leptun/leptunKicadLib/SR4G080.step

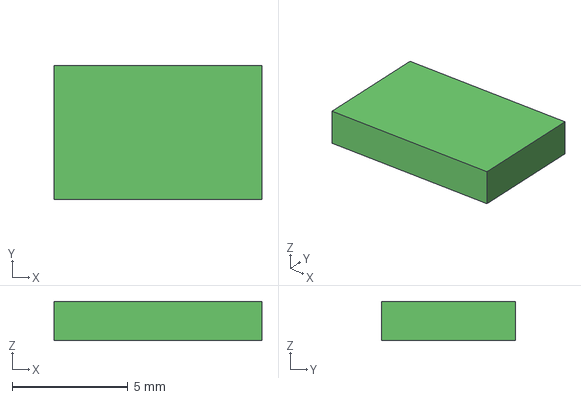
[picture p1: CAD file, 2023-09-09]
SR4G080.step
9.00 x 5.80 x 1.69 mm
