leptun/leptunKicadLib/TPS2053BDR.stp

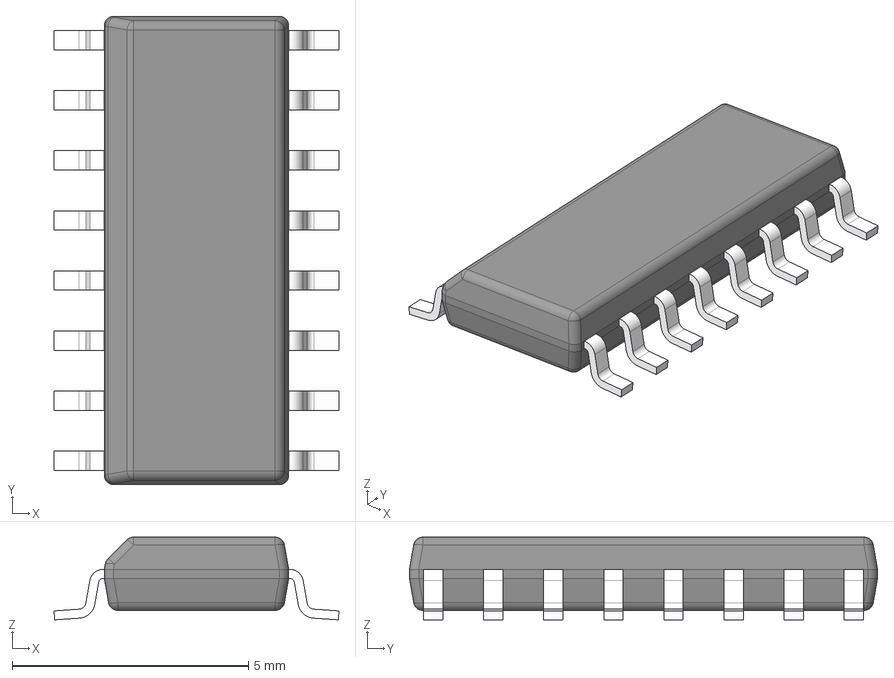
[picture p2: CAD file, 2023-08-23]
TPS2053BDR.stp
6.03 x 9.90 x 1.75 mm
BODY-SO
LEAD-SO x 16
PIN1-ID
