leptun/leptunKicadLib/PI3USB4000DZUAEX.stp

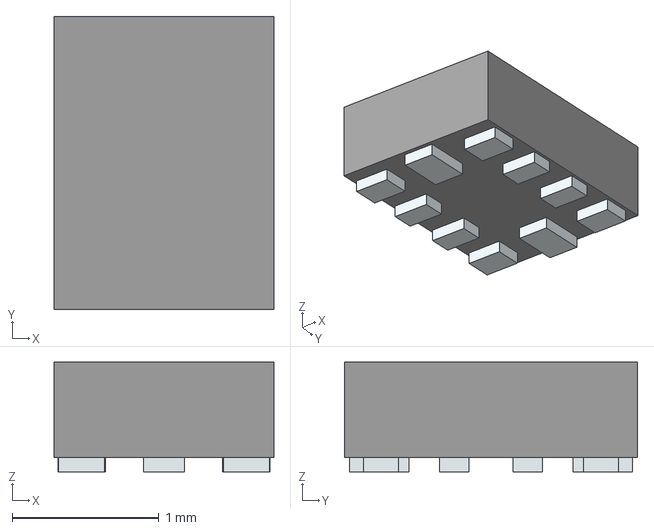
[picture p3: CAD file, 2023-08-23]
PI3USB4000DZUAEX.stp
1.50 x 2.00 x 0.75 mm
Pins
