leptun/leptunKicadLib/33UBAR-TSN1R.stp

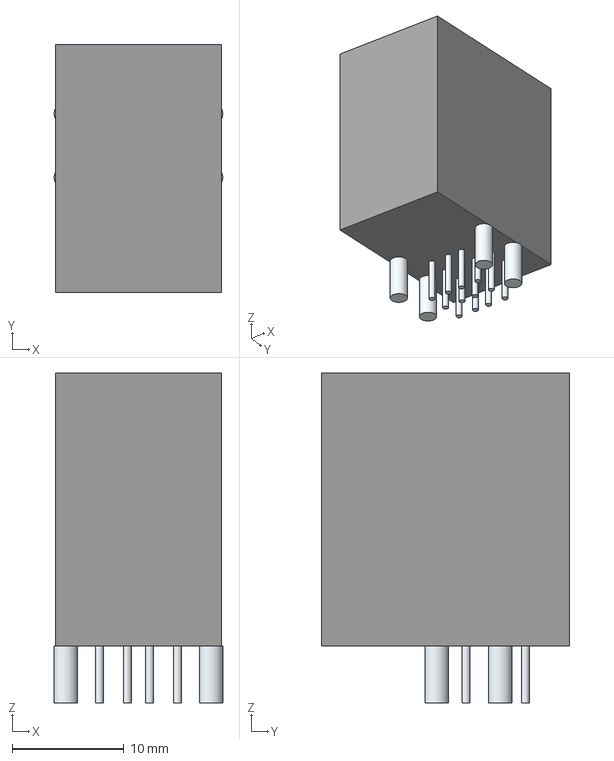
[picture p4: CAD file, 2023-08-23]
33UBAR-TSN1R.stp
15.1 x 22.2 x 29.6 mm
Leads
