leptun/leptunKicadLib/MC74VHC1G08DBVT1G.stp

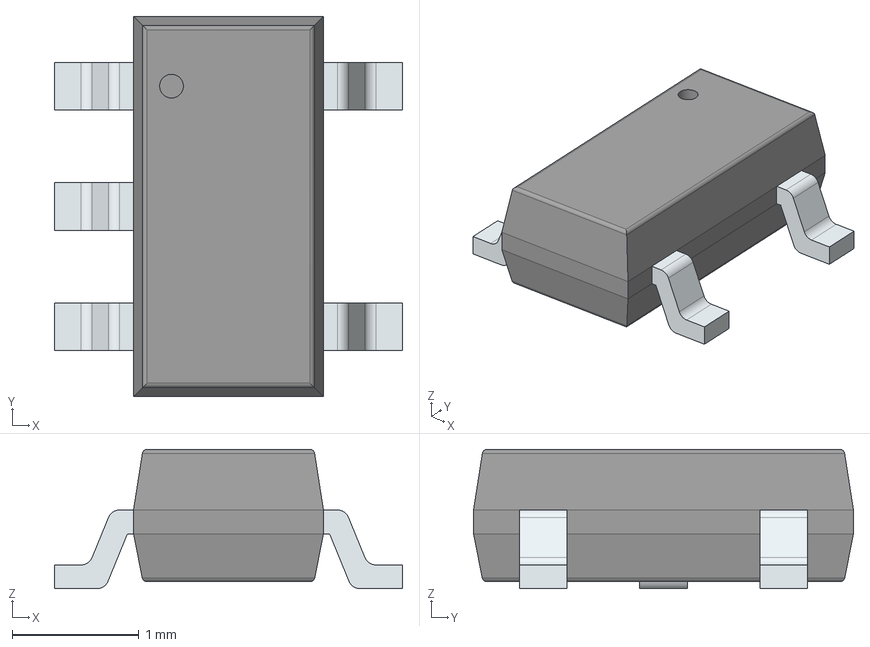
[picture p5: CAD file, 2023-08-23]
MC74VHC1G08DBVT1G.stp
2.75 x 3.00 x 1.10 mm
PinsArrayL
PinsArrayR
