leptun/leptunKicadLib/TS5USBC412YFFR.stp

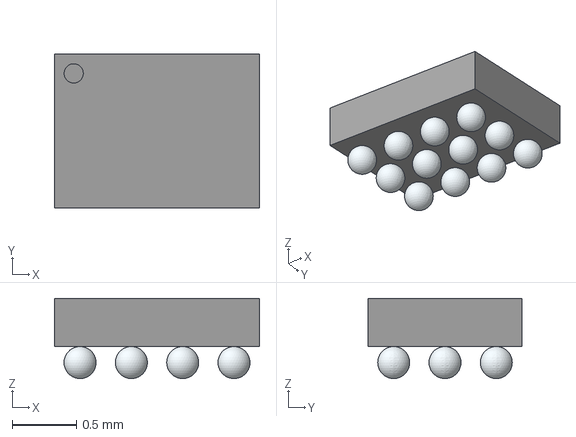
[picture p6: CAD file, 2023-08-23]
TS5USBC412YFFR.stp
1.60 x 1.20 x 0.625 mm
