leptun/leptunKicadLib/FSM4JSMAATR.stp

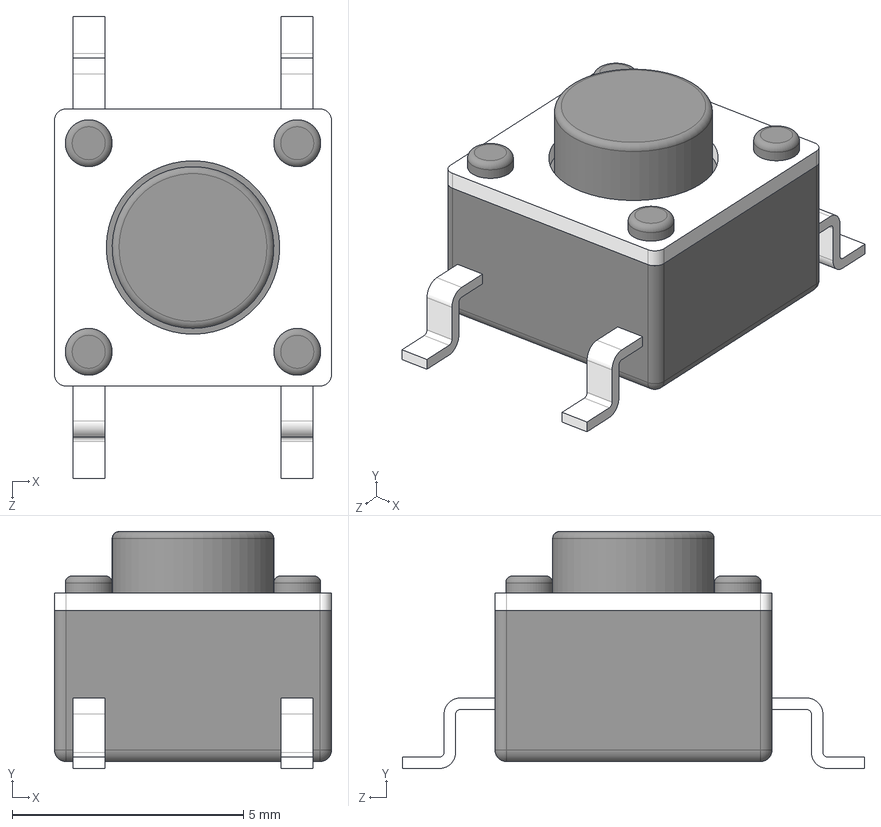
[picture p7: CAD file, 2023-08-23]
FSM4JSMAATR.stp
6.00 x 5.13 x 10.0 mm
