leptun/leptunKicadLib/DTSM-61N-V-T_R.step

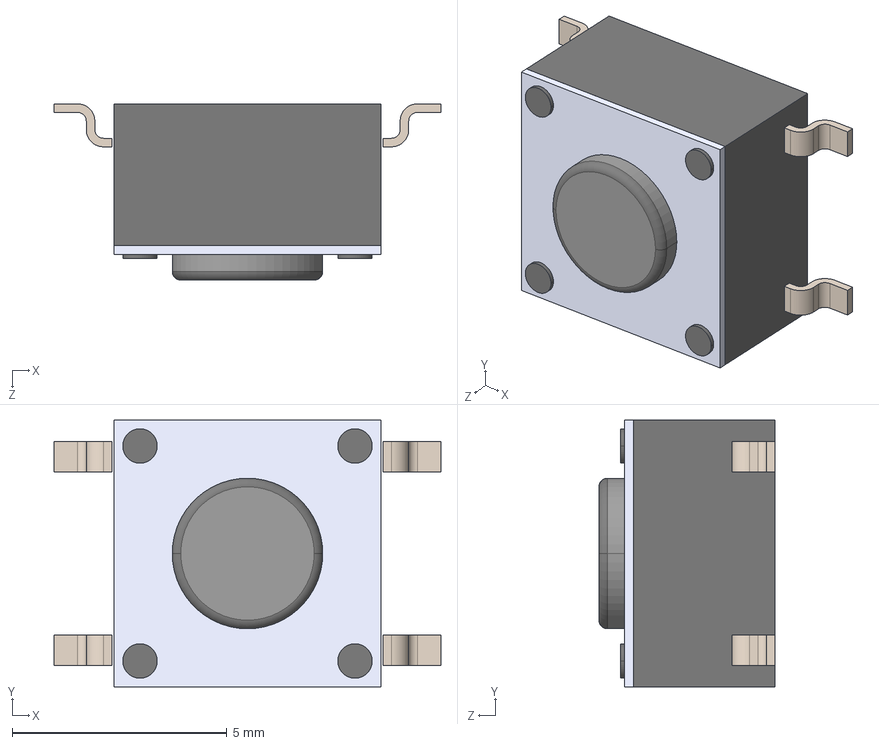
[picture p8: CAD file, 2021-10-09]
DTSM-61N-V-T_R.step
9.00 x 6.20 x 4.10 mm
