leptun/leptunKicadLib/AOZ1212AI.step

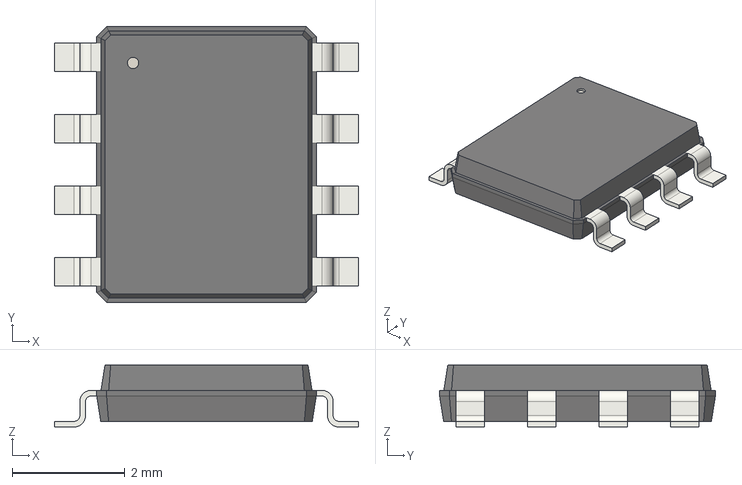
[picture p9: CAD file, 2021-10-09]
AOZ1212AI.step
5.40 x 4.90 x 1.10 mm
