leptun/leptunKicadLib/SRP6530A-6R8M.stp

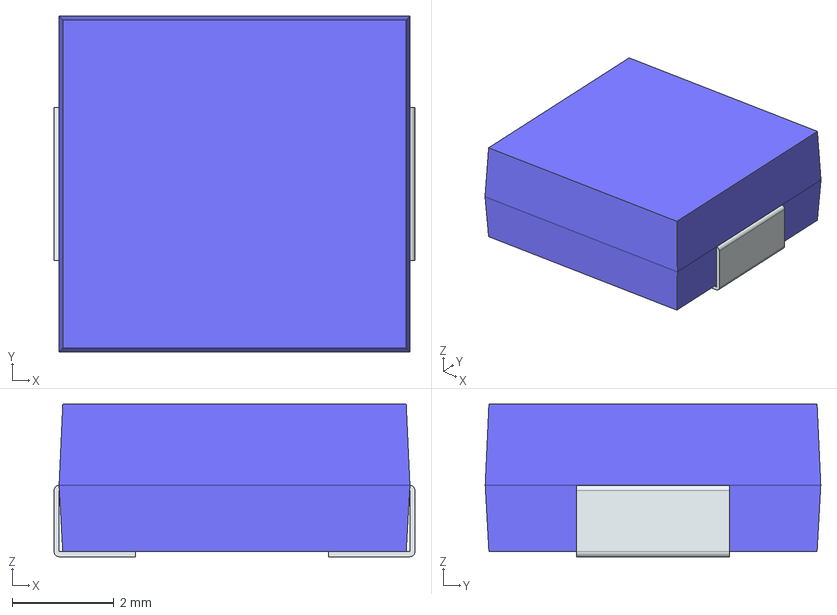
[picture p10: CAD file, 2021-10-09]
SRP6530A-6R8M.stp
7.10 x 6.60 x 3.00 mm
FilletPin1
FilletPin2
