leptun/leptunKicadLib/ATS240C.STEP

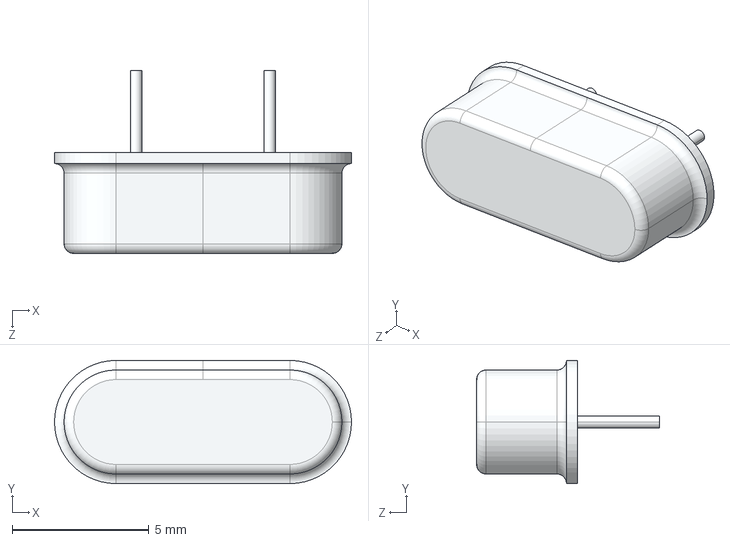
[picture p11: CAD file, 2021-10-09]
ATS240C.STEP
10.8 x 4.50 x 6.68 mm
