leptun/leptunKicadLib/STM32G441KBU6.stp

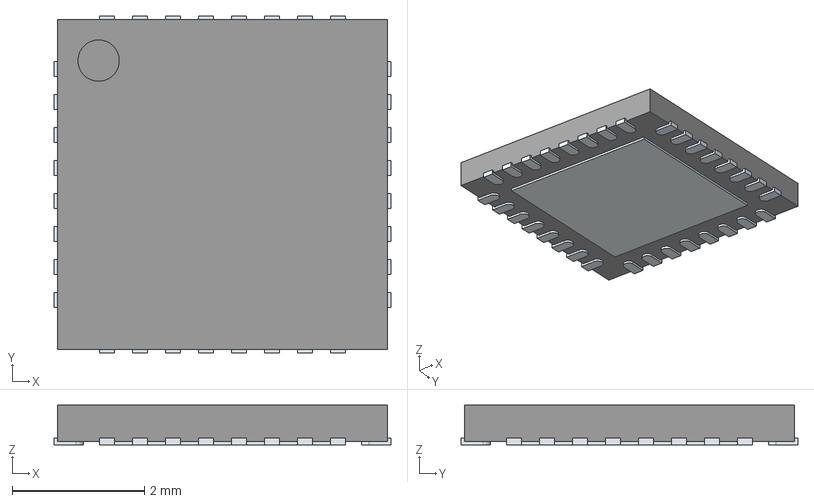
[picture p12: CAD file, 2021-10-09]
STM32G441KBU6.stp
5.10 x 5.10 x 0.6 mm
ThermalPin
PinsArrayLR
PinsArrayTB
