leptun/leptunKicadLib/FTSH-107-01-L-DV-K-A.stp

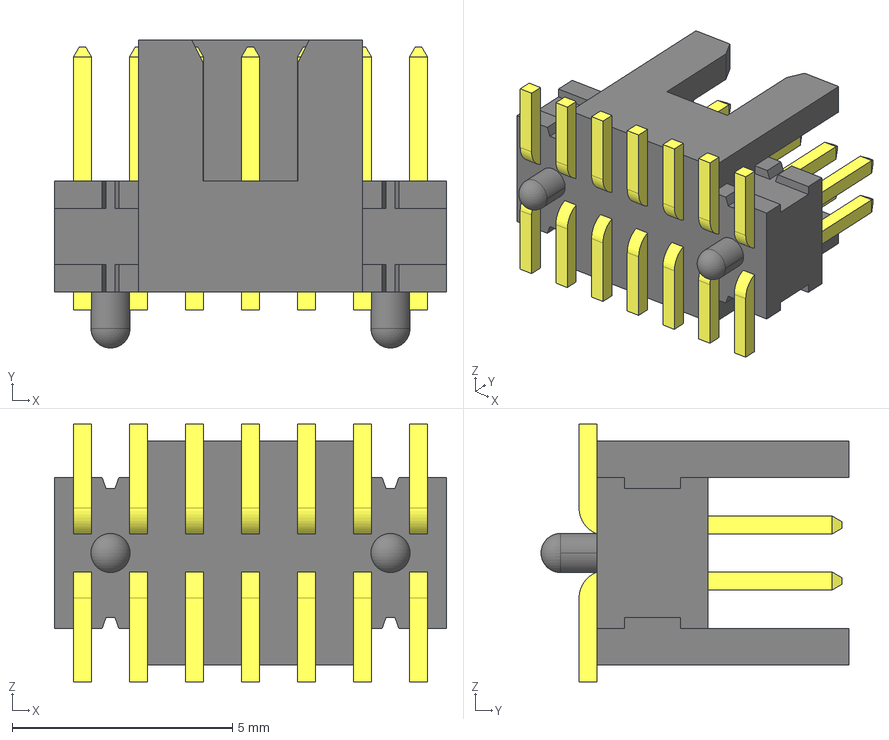
[picture p13: CAD file, 2021-10-09]
FTSH-107-01-L-DV-K-A.stp
8.89 x 6.98 x 5.84 mm
