leptun/leptunKicadLib/TS3USBCA420RSVR.stp

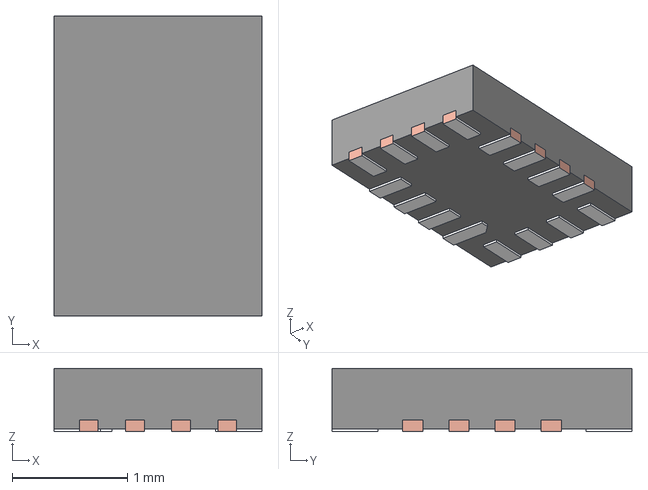
[picture p14: CAD file, 2021-10-08]
TS3USBCA420RSVR.stp
1.80 x 2.60 x 0.55 mm
BODY-SON1
FRAME-RSV0016A
