leptun/leptunKicadLib/USB4110-GF-A.stp

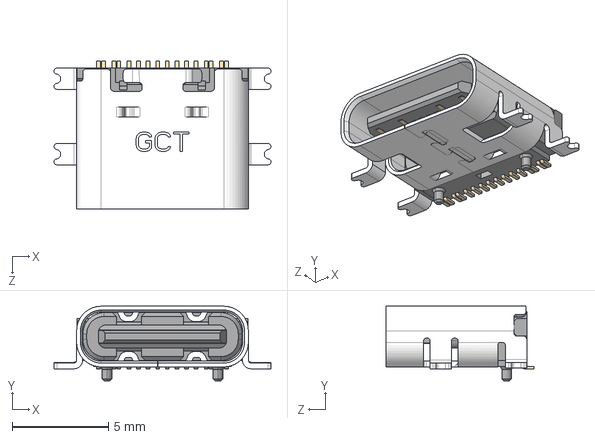
[picture p15: CAD file, 2021-10-08]
USB4110-GF-A.stp
11.3 x 3.89 x 7.70 mm
