leptun/leptunKicadLib/61200621621.stp

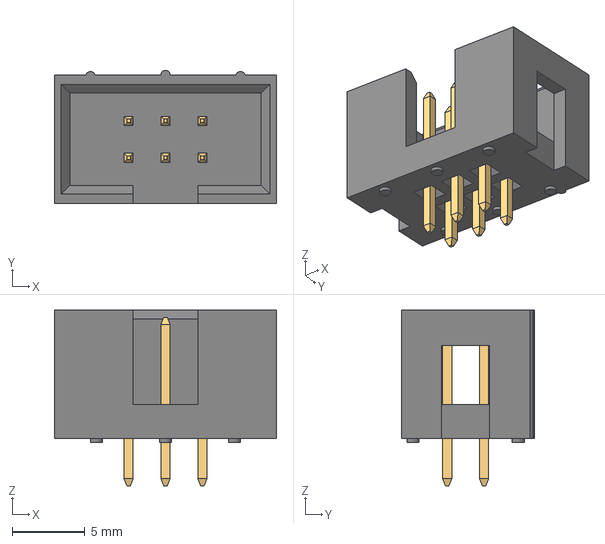
[picture p16: CAD file, 2024-04-30]
61200621621.stp
15.3 x 9.18 x 12.1 mm
6120xx21621_PIN x 6
