leptun/leptunKicadLib/61729-1011RLF.stp

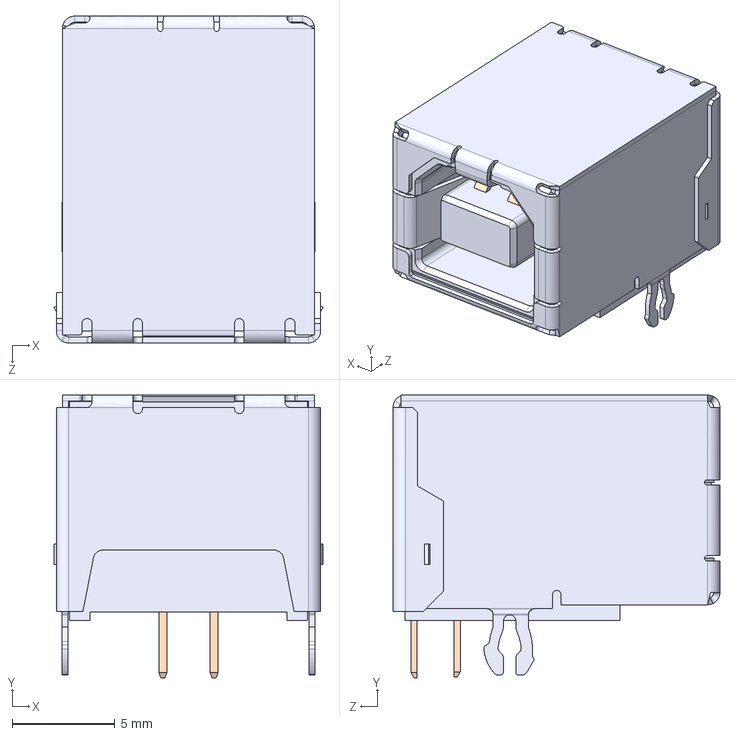
[picture p17: CAD file, 2023-08-23]
61729-1011RLF.stp
13.1 x 13.8 x 15.9 mm
