leptun/leptunKicadLib/61201021621.step

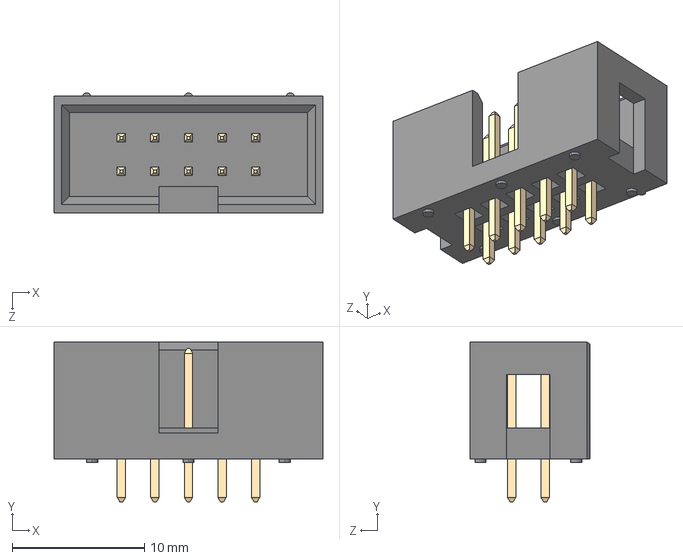
[picture p18: CAD file, 2022-06-12]
61201021621.step
20.4 x 12.1 x 9.10 mm
