leptun/leptunKicadLib/(list of files, cad)

Other CAD files:
67068-9000.stp
67643-0910.stp
ATS240C.SLDPRT
