leptun/leptunKicadLib/(commit log)

2021-10-09 Fix FTSH-107-01-L-DV-K-A 3D model
    [FTSH-107-01-L-DV-K-A.stp]
2023-08-23 MUXUS rev2 dump
    [33UBAR-TSN1R.stp, 61729-1011RLF.stp, FSM4JSMAATR.stp, MC74VHC1G08DBVT1G.stp, PI3USB4000DZUAEX.stp, TPS2053BDR.stp, TS5USBC412YFFR.stp]
2023-08-23 Lanco led logo dump
2023-09-20 Fix 61201021621 footprint
2024-04-30 Make pin1 rectangular
    [61200621621.stp]
